anujajoshi758/Instrument-Droid/README.md

# Instrument-Droid
[Report Link](https://github.com/anujajoshi758/Instrument-Droid/blob/main/anuja_Instrument%20Droid_report.pdf)
