anujajoshi758/Instrument-Droid/anuja_Instrument Droid_report.pdf

## Board 4: Instrument Droid

Objective:

To design and implement a 4-layer standalone board using the ATmega328 microcontroller that can measure the Thevenin equivalent resistance of various DC voltage sources by sensing voltage and current under controlled load conditions.

Bill of Material:

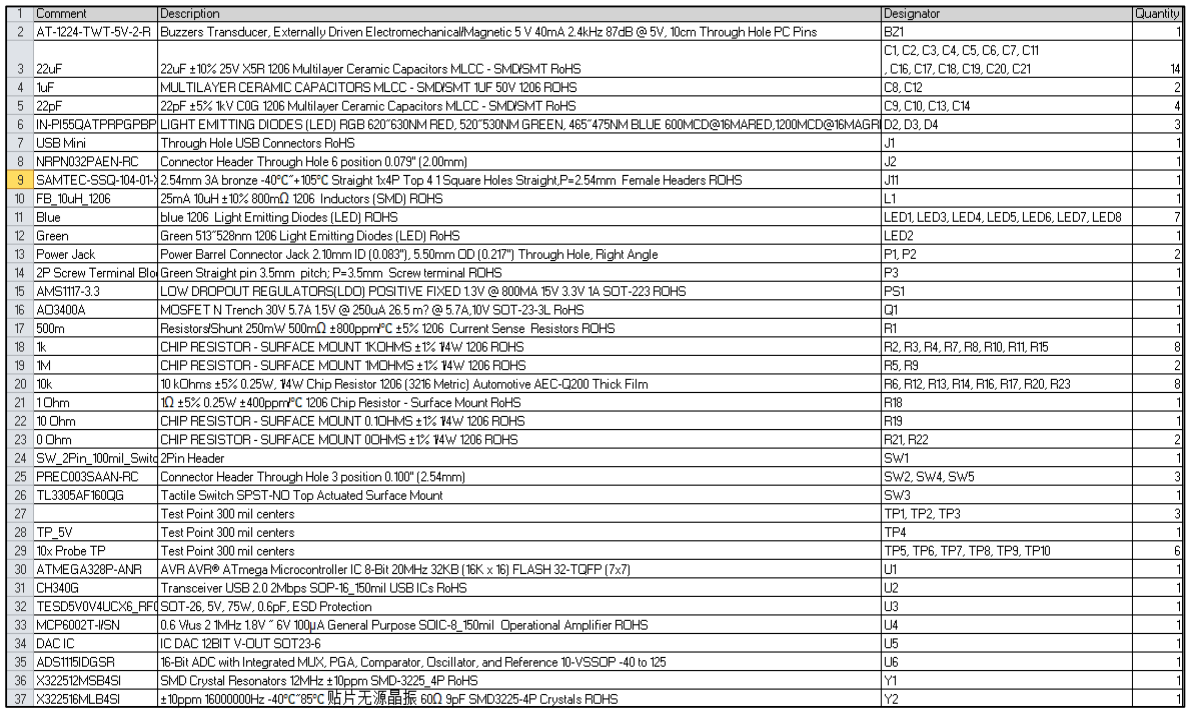
[picture p1: figure]
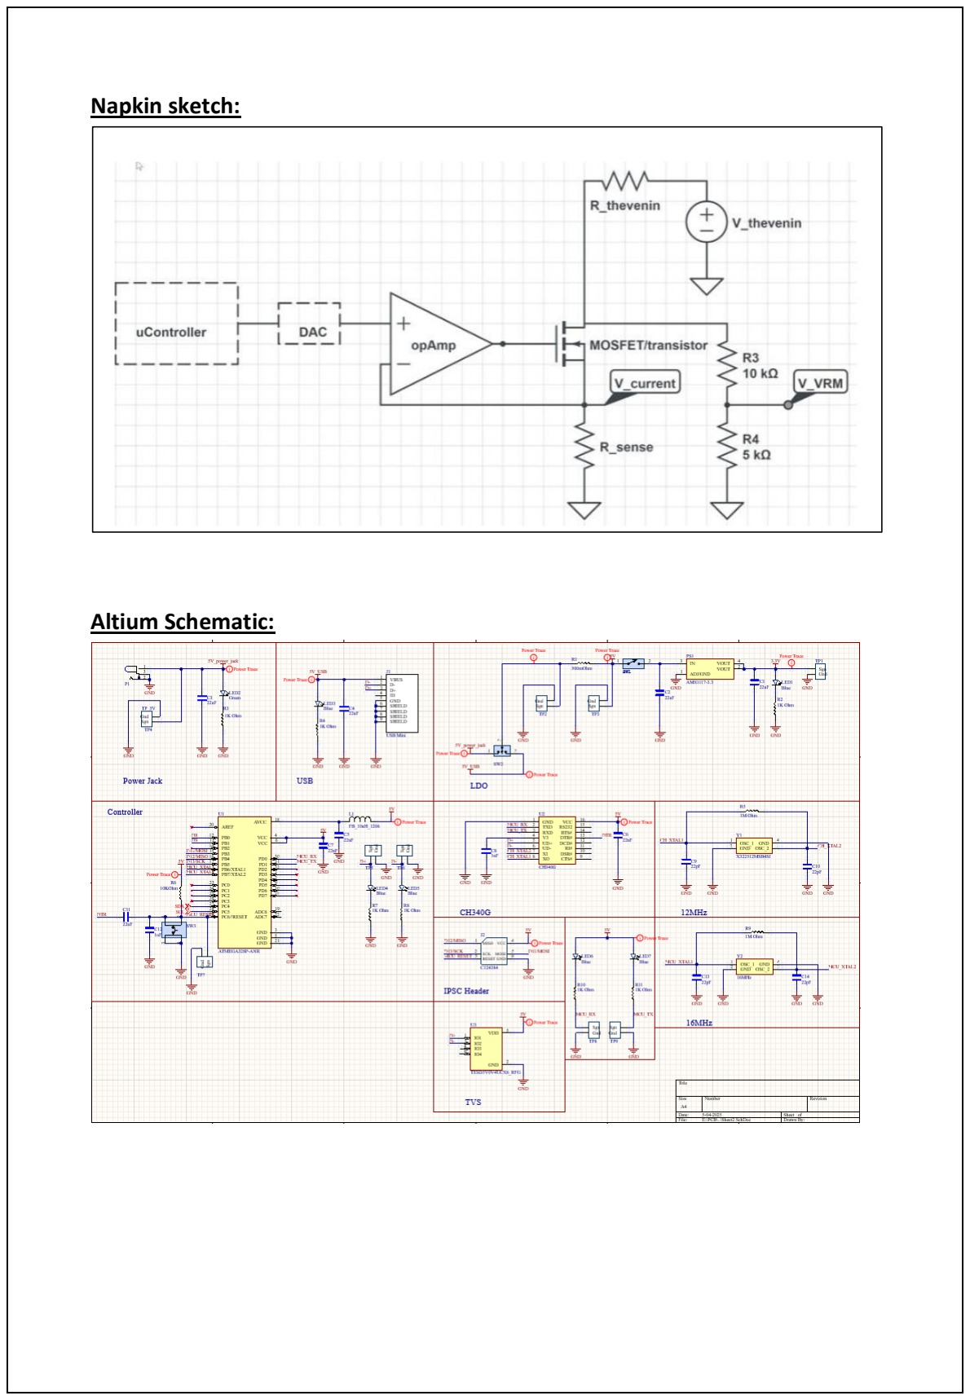
[picture p2: page 2]

Napkin sketch:

Altium Schematic:

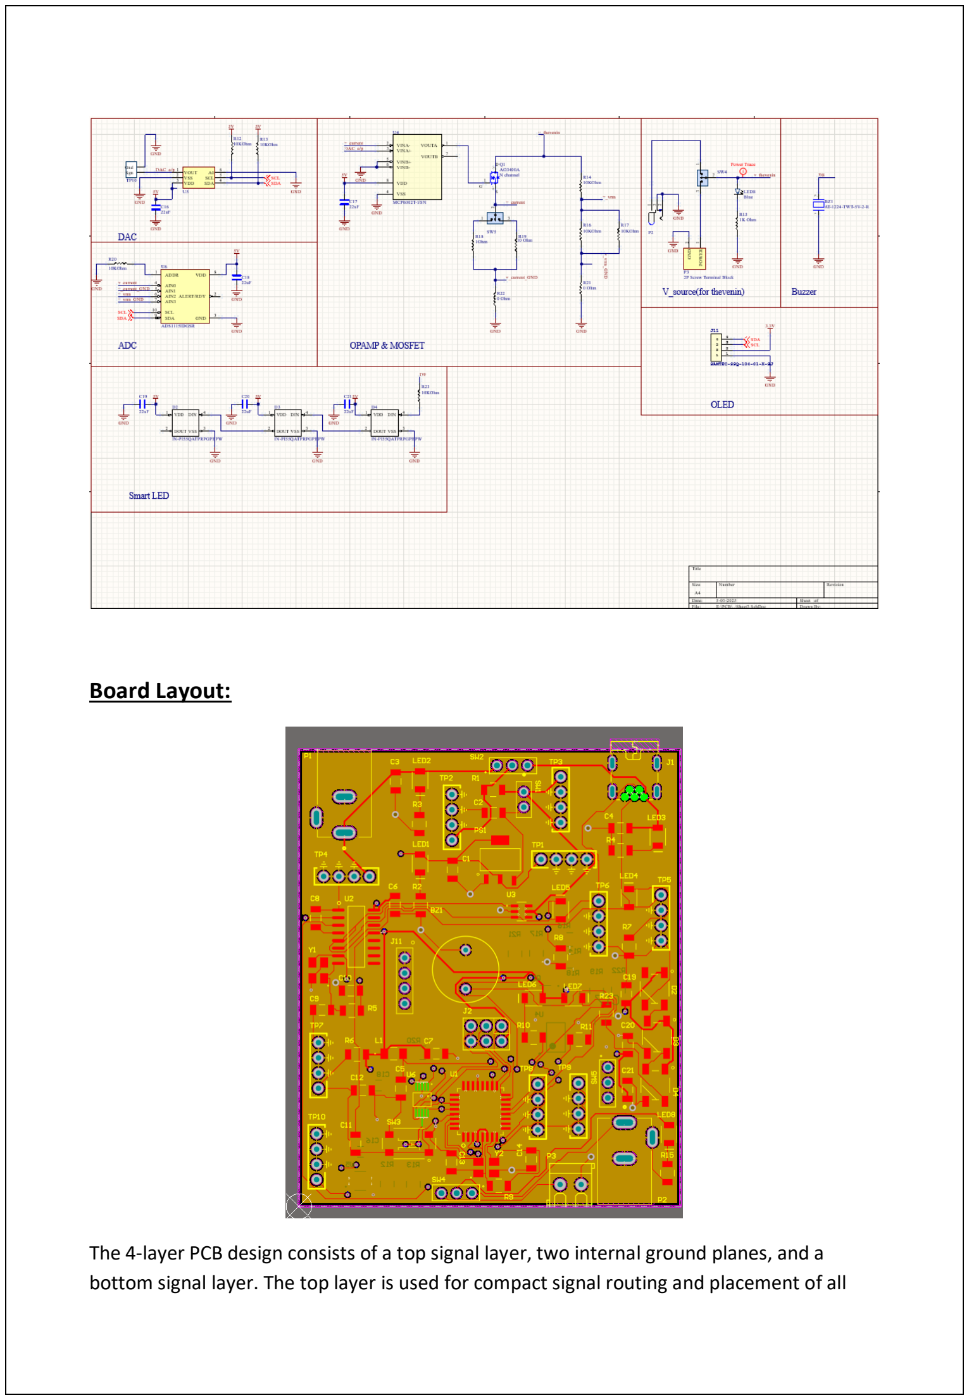
[picture p3: page 3]

Board Layout:

The 4-layer PCB design consists of a top signal layer, two internal ground planes, and a bottom signal layer. The top layer is used for compact signal routing and placement of all surface-mount components. Inner layer 1 serves as the primary ground plane, ensuring lowimpedance return paths for top-layer signals and reducing EMI. Inner layer 2 acts as a secondary ground plane, supporting high-current return paths. The bottom layer is utilized for additional signal routing, power distribution, and interfacing with through-hole connectors and test points.

Board Pictures:

Before assembly:

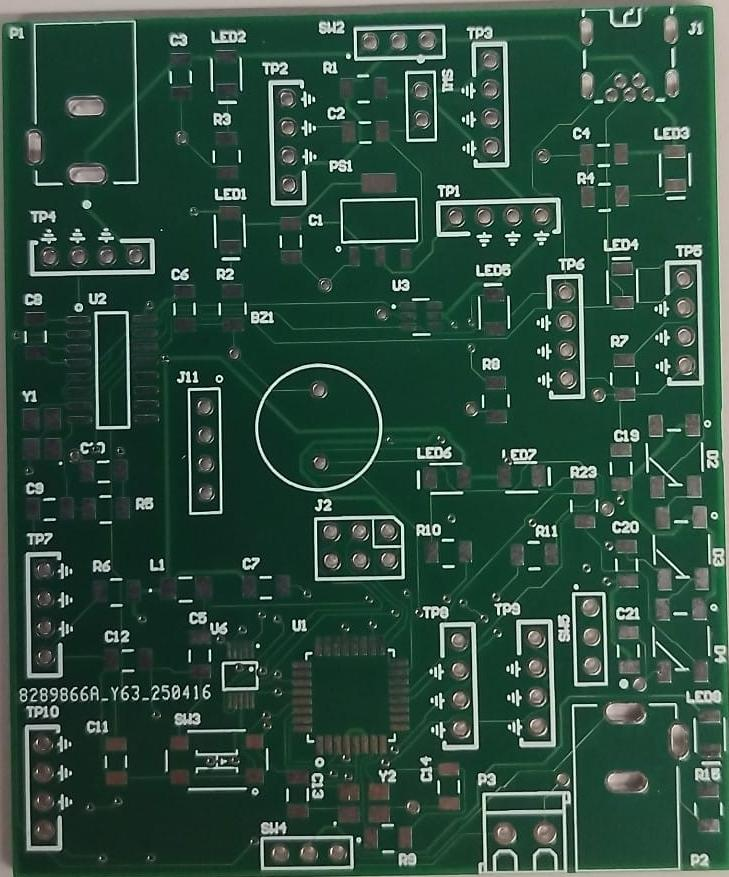
[picture p4: figure]

After assembly:

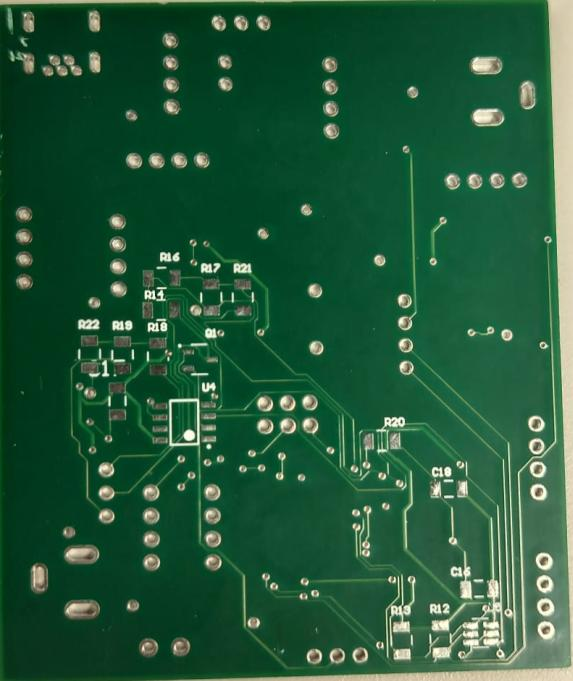
[picture p5: figure]

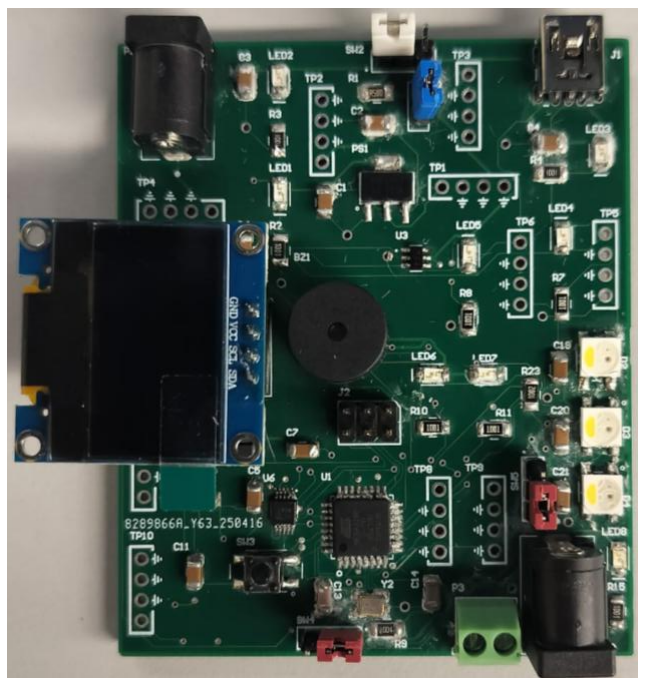
[picture p6: figure]

Plan of Record:

Power

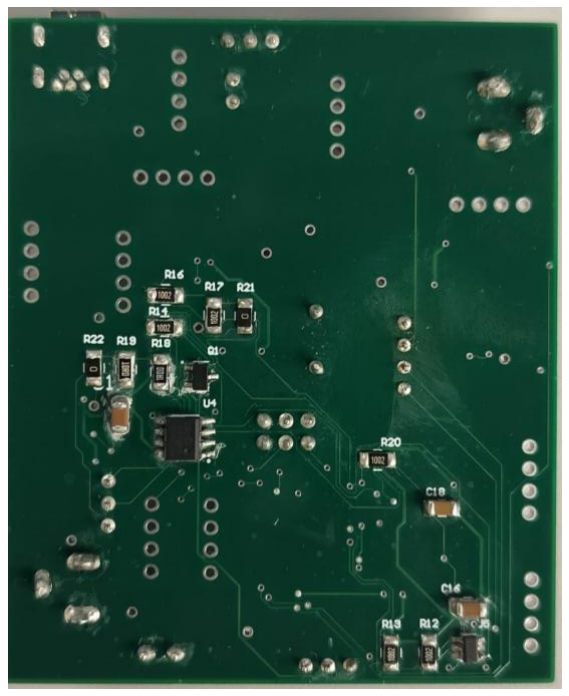
[picture p7: figure]

- Power jack for a standard “AC-to-5 V DC” adaptor (primary board supply).
- One more power jack and two-pin screw terminal for the external source whose Rthev is being measured.
- On-board slide switch selects either power jack or two pin screw terminal as the local 5 V logic supply.
- 500m ohm current-sense resistor in series with the main rail, plus nearby test pad for inrush-current probing.

Source-Under-Test

- MCP4725 12-bit DAC → MCP6002 rail-to-rail op-amp → MOSFET forms a closed-loop electronic load.
- Slide switch selects 1 ohm or 10ohm sense network at the MOSFET source to extend current range.

Measurement

- Ferrite bead on AVCC isolates the ADC/DAC analog rail from digital noise.

Bootloading

- ATmega328-P clocked by a 16 MHz crystal boot-flash accessible through a 6-pin ICSP header and isolation-header jumpers.

- CH340G (12 MHz crystal) provides USB-to-UART bridge on a mini-B connector protected by a USB-line TVS diode.

User Interface

- OLED displays real-time Rthev, load current, and rail voltage.
- Three smart LEDs.
- 5 V buzzer

Connectivity & Debug

- Labeled test.
- Isolation headers for the ATmega328 I/O and power to support subsystem bring-up.

WHAT WORKED:

Board bring up:

1. Power Indicators:

The board was successfully powered up and verified for functionality. The OLED display correctly shows real-time readings of current, voltage, and calculated Thevenin resistance. Multiple indicator LEDs are active, signaling proper power distribution, program execution, and system status. The buzzer is mounted and functional, providing audible feedback during operation. All subsystems—including power input, USB serial interface, Atmega328 bootload, OLED, DAC, ADC, MOSFET load path, and user interface—were confirmed operational during the initial bring-up.

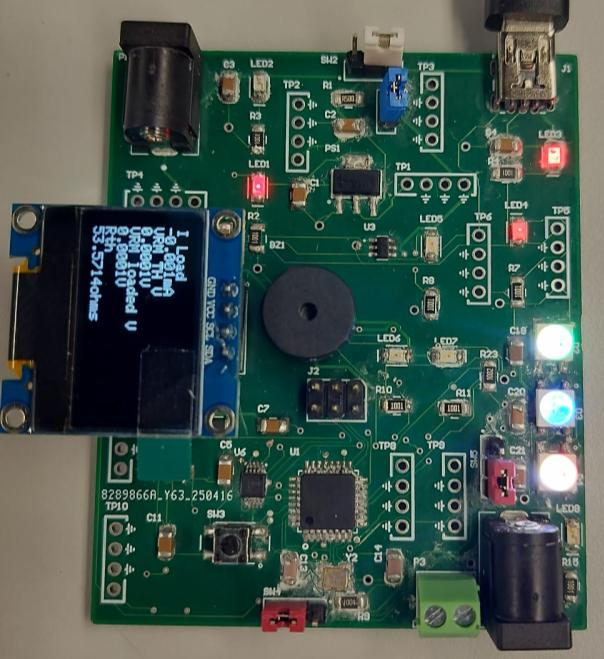
[picture p8: figure]
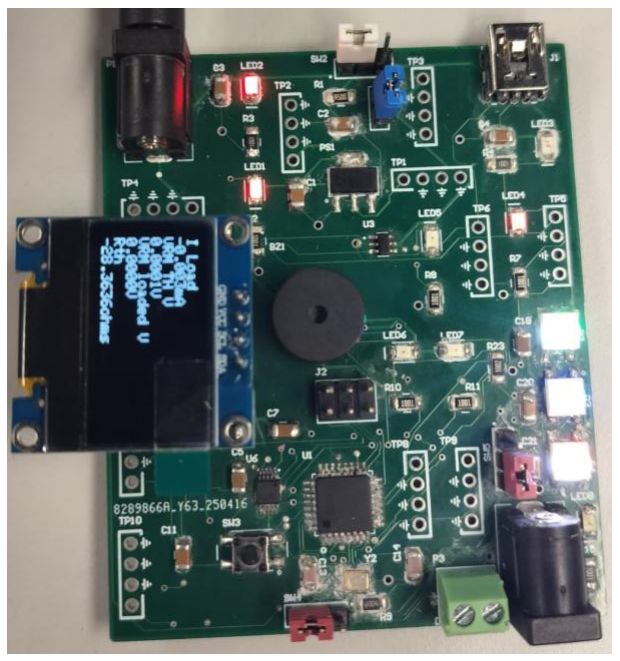
[picture p9: figure]

Power on using power USB | Power on using power jack

2. Power Source Switching:

The switch correctly toggles between USB and power (jack), with seamless power transition observed and no voltage dips.

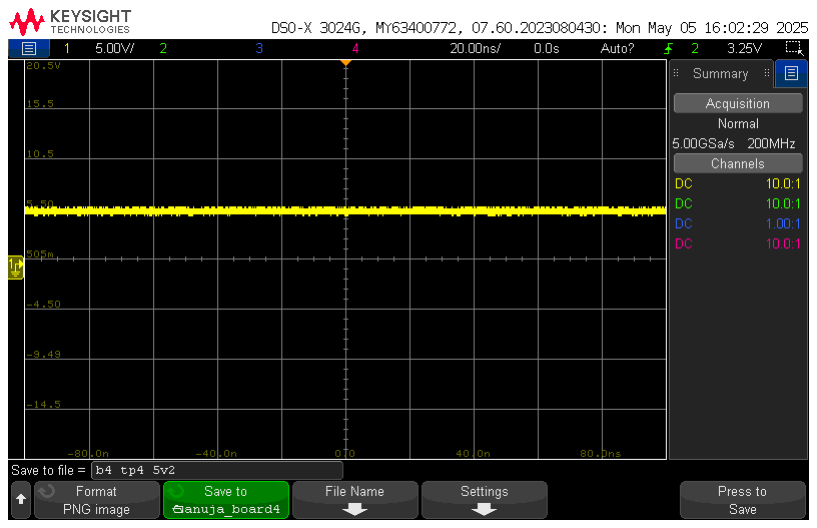
[picture p10: figure]

3. 3.3V LDO Output Verification: A stable 3.3V output was observed on the corresponding test point, confirming proper operation of the LDO regulator.

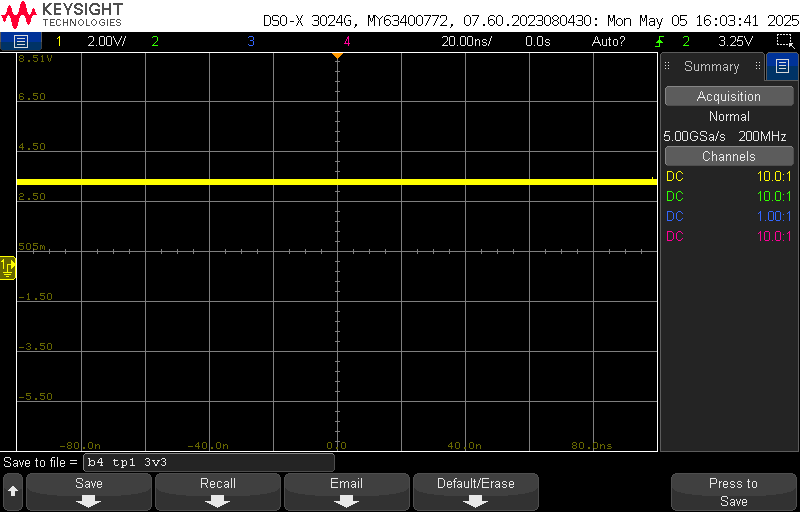
[picture p11: figure]

4. Bootloading the ATmega328:
The ATmega328 microcontroller was successfully bootloaded using a commercial Arduino Uno configured as an ISP programmer. Bootloader functionality was confirmed through successful detection in the Arduino IDE and successful sketch uploads. The crystal oscillators were verified for correct operation—16 MHz for the ATmega328 and 12 MHz for the CH340G USB-to-UART converter.

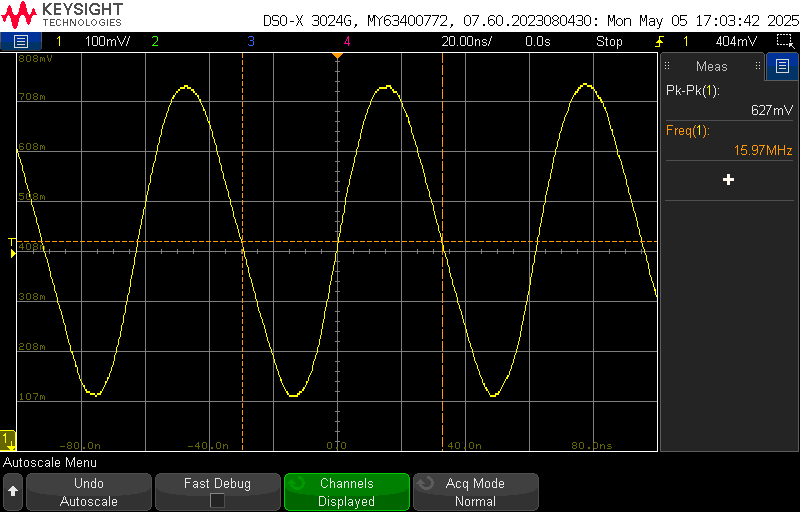
[picture p12: figure]

16MHz

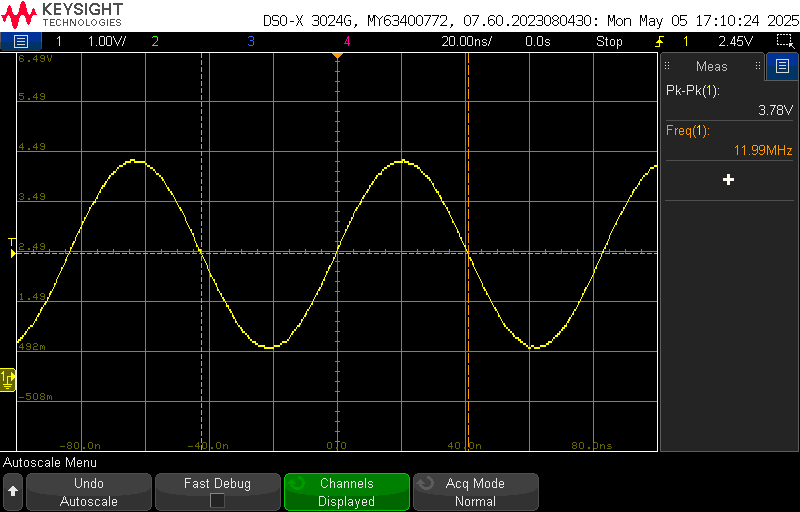
[picture p13: figure]

12MHz

5. Code Flashing and UART Communication:
Firmware was successfully flashed to the ATmega328 via the CH340G USB-to-UART interface. Oscilloscope captures on USB D+/D– lines and UART RX/TX lines confirmed active data transmission during code upload, verifying proper communication and functionality of the CH340G interface.

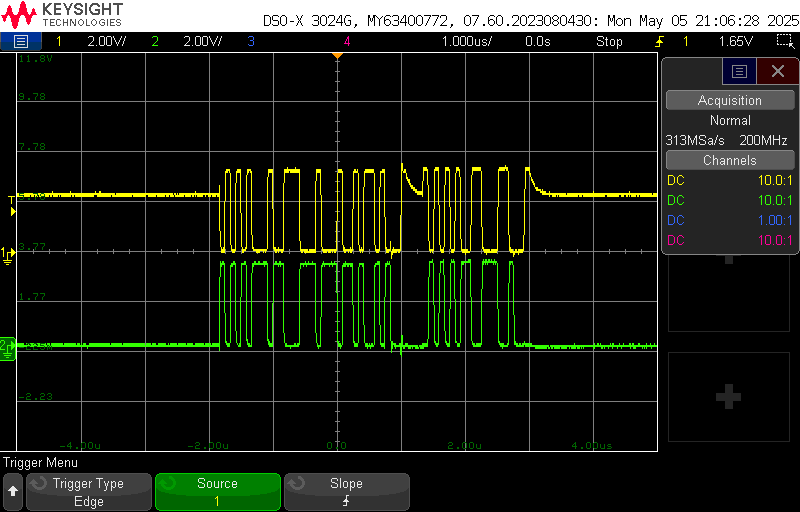
[picture p14: figure]

D+/D-

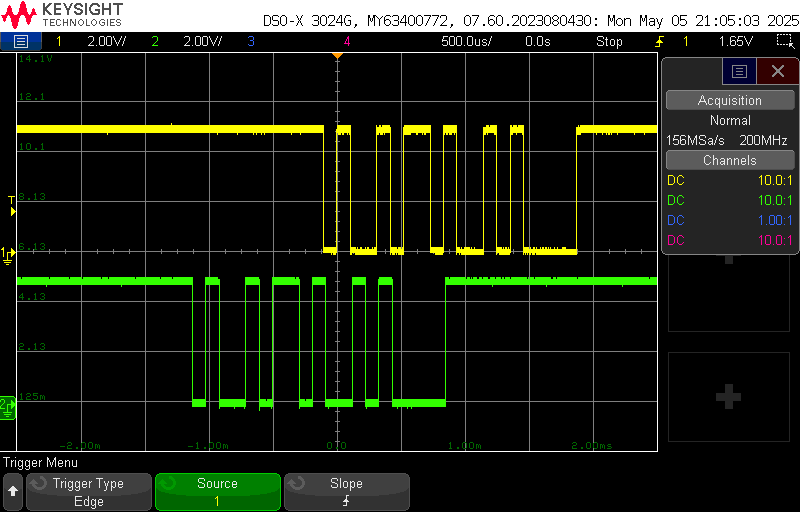
[picture p15: figure]

Tx/Rx

### 6. Flashing Buzzer and Smart LED Test Code:

Uploaded a basic test sketch via the Arduino IDE to verify functionality of the buzzer and smart LEDs. The buzzer activated with a short tone and the LEDs cycled through colors. Please find the attached code at the provided link. Check the link for the demo

demo.mp4 (https://o365coloradoedu-my.sharepoint.com/:v:/g/personal/anjo6767_colorado_edu/ETvTsv99MuFHioioCC0A-IgBFFIWDzbZSyg_gIc26YpI-w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)

7. Testing reset:
7. DAC output:

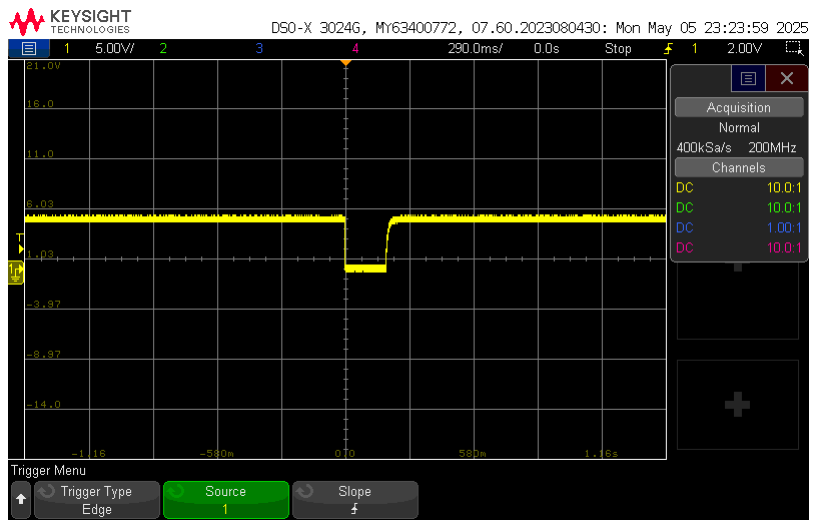
[picture p16: figure]
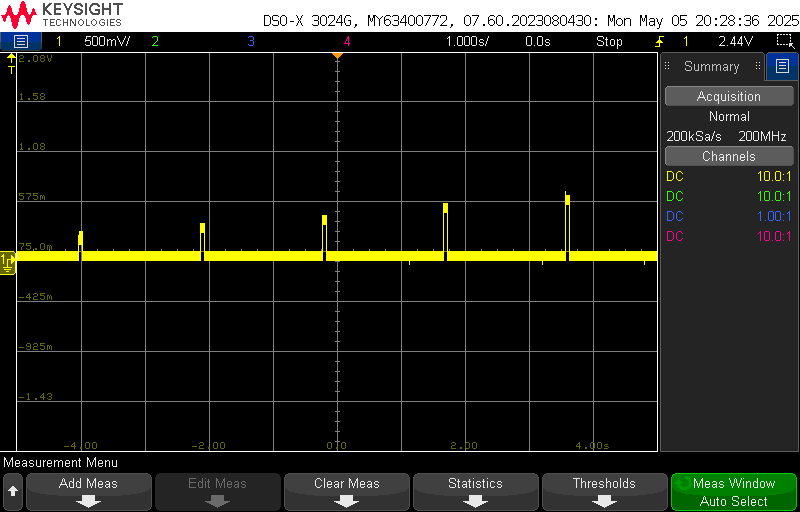
[picture p17: figure]

8. MOSFET gate

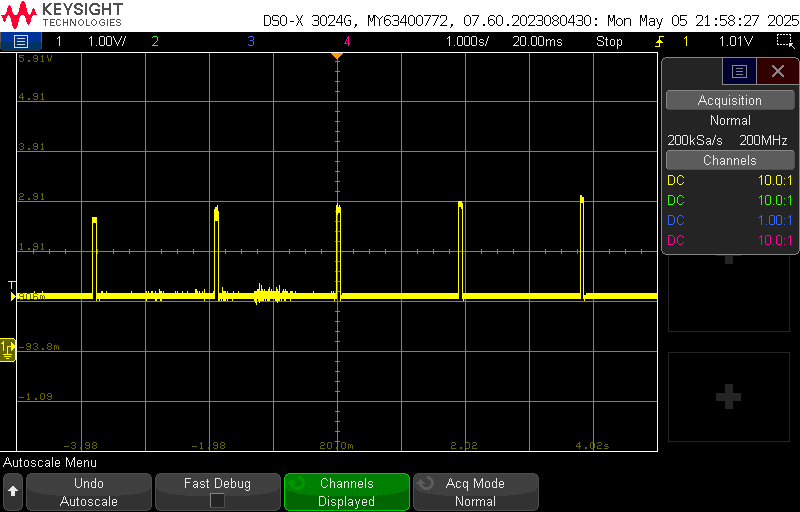
[picture p18: figure]

What Did Not Work:
All components and functionalities operated as intended. No hardware or software issues were encountered during bring-up and testing.

Measurement of Output Resistance for Connected Voltage Sources:

1. 5V adapter

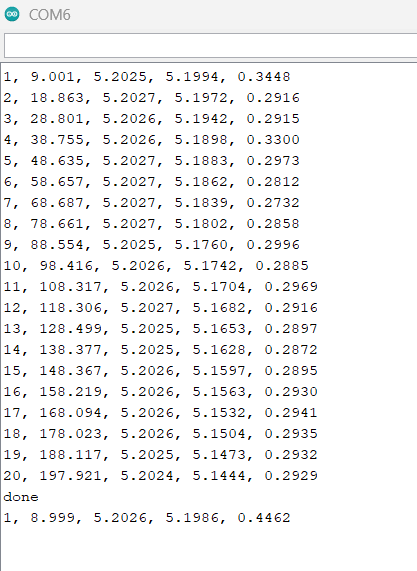
[picture p19: figure]
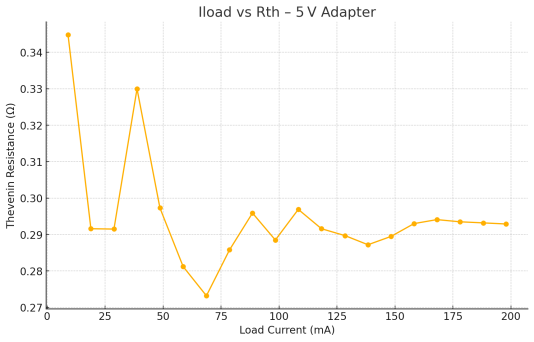
[picture p20: figure]

2. Function generator 5V:

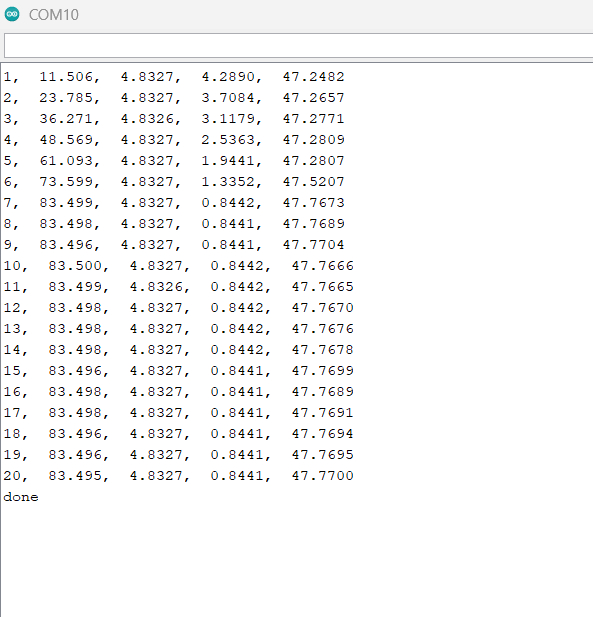
[picture p21: figure]

4. Function generator 9V:

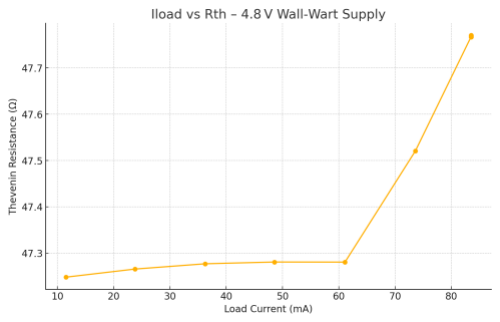
[picture p22: figure]
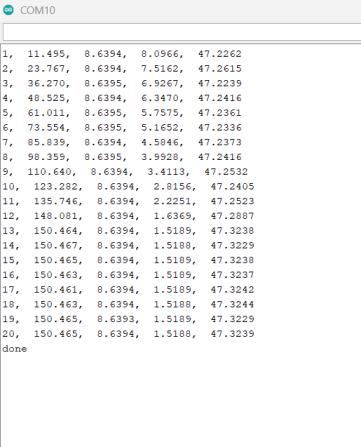
[picture p23: figure]
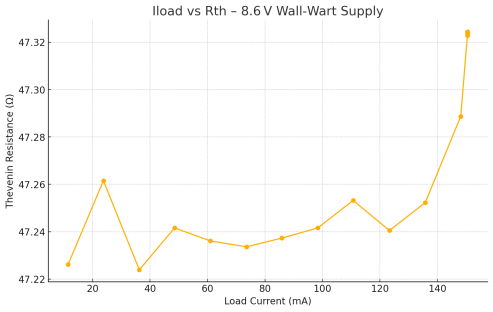
[picture p24: figure]

The instrument droid accurately measured the power adapter near-constant ≈ 47 ohm output resistance and the switch-mode adapter’s flat ≈ 0.30 ohm output resistance, demonstrating its ability to distinguish high and low impedance sources.

Conclusion:
The instrument-droid project successfully met all stated objectives: design, fabrication, bring-up, and validation of a standalone 4-layer ATmega328-based board capable of characterizing the Thevenin output resistance of DC sources up to 12 V. Hardware bring-up verified every subsystem—power inputs, USB–UART (CH340G), bootloader access, OLED display, DAC/ADC chain, MOSFET electronic load, smart LEDs, and buzzer—without encountering hardware or software faults.

Key learnings:

GPIO Silkscreen Matters: Unlabeled pins significantly slowed troubleshooting; clear GPIO labels streamline testing and save time.

ICs First: Reflowing the fine-pitch ICs before resistors, capacitors, and jumpers minimizes alignment issues and simplifies later hand-soldering.

Solder Paste Proficiency: Gained hands-on experience soldering components using solder paste, resulting in cleaner and more reliable joints for SMT parts.
