anujajoshi758/Instrument-Droid/PCB_board4_BOM.xlsx

Comment | Description | Designator | Footprint | LibRef | Quantity
AT-1224-TWT-5V-2-R | Buzzers Transducer, Externally Driven Electromechanical/Magnetic 5 V 40mA 2.4kHz 87dB @ 5V, 10cm Through Hole PC Pins | BZ1 | BUZZER- TH | BUZZER_1 | 1
22uF | 22uF ±10% 25V X5R 1206 Multilayer Ceramic Capacitors MLCC - SMD/SMT RoHS | C1, C2, C3, C4, C5, C6, C7, C11, C16, C17, C18, C19, C20, C21 | 1206_Passive_Capacitor | C_22uF_1206 | 14
1uF | MULTILAYER CERAMIC CAPACITORS MLCC - SMD/SMT 1UF 50V 1206 ROHS | C8, C12 | 1206_Passive_Capacitor | C_1uF_1206 | 2
22pF | 22pF ±5% 1kV C0G 1206 Multilayer Ceramic Capacitors MLCC - SMD/SMT RoHS | C9, C10, C13, C14 | 1206_Passive_Capacitor | C_22pF_1206 | 4
IN-PI55QATPRPGPBPW | LIGHT EMITTING DIODES (LED) RGB 620~630NM RED, 520~530NM GREEN, 465~475NM BLUE 600MCD@16MARED,1200MCD@16MAGREEN,300MCD@16MABLUE TOP VIEW SMD-4 ROHS | D2, D3, D4 | SERIAL_LED - duplicate | LED_Smart | 3
USB Mini | Through Hole USB Connectors RoHS | J1 | USB_MINI_B | J_USB_B_Mini | 1
NRPN032PAEN-RC | Connector Header Through Hole 6 position 0.079" (2.00mm) | J2 | ICSP | J_ICSP | 1
SAMTEC-SSQ-104-01-X-SJ | 2.54mm 3A bronze -40℃~+105℃ Straight 1x4P Top 4 1 Square Holes Straight,P=2.54mm Female Headers ROHS | J11 | JF-4_SSQ-104-01-X-S | JF_4_PIN_FEMALE | 1
FB_10uH_1206 | 25mA 10uH ±10% 800mΩ 1206 Inductors (SMD) ROHS | L1 | AIML-1206_ABR-M | FB_10uH_1206 | 1
Blue | blue 1206 Light Emitting Diodes (LED) ROHS | LED1, LED3, LED4, LED5, LED6, LED7, LED8 | LED_1206 | LED_BLUE_1206 | 7
Green | Green 513~528nm 1206 Light Emitting Diodes (LED) RoHS | LED2 | LED_1206 | LED_GREEN_1206 | 1
Power Jack | Power Barrel Connector Jack 2.10mm ID (0.083"), 5.50mm OD (0.217") Through Hole, Right Angle | P1, P2 | Power_Jack | P_Power Jack | 2
2P Screw Terminal Block | Green Straight pin 3.5mm pitch; P=3.5mm Screw terminal ROHS | P3 | P_Terminal block 3.5mm-pitch | P_Terminal block | 1
AMS1117-3.3 | LOW DROPOUT REGULATORS(LDO) POSITIVE FIXED 1.3V @ 800MA 15V 3.3V 1A SOT-223 ROHS | PS1 | LDO | PS_AMS_LDO_3v3 | 1
AO3400A | MOSFET N Trench 30V 5.7A 1.5V @ 250uA 26.5 m? @ 5.7A,10V SOT-23-3L RoHS | Q1 | N-MOSFET | Q_Nch_MOSFET | 1
500m | Resistors/Shunt 250mW 500mΩ ±800ppm/℃ ±5% 1206 Current Sense Resistors ROHS | R1 | 1206_Passive_Resitor | R_500mOhm_1206 | 1
1k | CHIP RESISTOR - SURFACE MOUNT 1KOHMS ±1% 1/4W 1206 ROHS | R2, R3, R4, R7, R8, R10, R11, R15 | 1206_Passive_Resitor | R_1K_1206 | 8
1M | CHIP RESISTOR - SURFACE MOUNT 1MOHMS ±1% 1/4W 1206 ROHS | R5, R9 | 1206_Passive_Resitor | R_1M_1206 | 2
10k | 10 kOhms ±5% 0.25W, 1/4W Chip Resistor 1206 (3216 Metric) Automotive AEC-Q200 Thick Film | R6, R12, R13, R14, R16, R17, R20, R23 | 1206_Passive_Resitor | R_10KOhm_1206 | 8
1 Ohm | 1Ω ±5% 0.25W ±400ppm/℃ 1206 Chip Resistor - Surface Mount RoHS | R18 | 1206_Passive_Resitor | R_1Ohm_1206 | 1
10 Ohm | CHIP RESISTOR - SURFACE MOUNT 0.1OHMS ±1% 1/4W 1206 ROHS | R19 | 1206_Passive_Resitor | R_10Ohm_1206 | 1
0 Ohm | CHIP RESISTOR - SURFACE MOUNT 0OHMS ±1% 1/4W 1206 ROHS | R21, R22 | 1206_Passive_Resitor | R_0Ohm_1206 | 2
SW_2Pin_100mil_Switch | 2Pin Header | SW1 | 2Pin-Header-Conn | SW_2Pin_100mil_Switch | 1
PREC003SAAN-RC | Connector Header Through Hole 3 position 0.100" (2.54mm) | SW2, SW4, SW5 | 3_PIN_100mil | SW_3Pin_100mil_Switch | 3
TL3305AF160QG | Tactile Switch SPST-NO Top Actuated Surface Mount | SW3 | Switch_JLC | SW_Push_Button_JLC | 1
 | Test Point 300 mil centers | TP1, TP2, TP3 | TP10x_Probe | TP_10x_Probe | 3
TP_5V | Test Point 300 mil centers | TP4 | TP10x_Probe | TP_10x_Probe | 1
10x Probe TP | Test Point 300 mil centers | TP5, TP6, TP7, TP8, TP9, TP10 | TP10x_Probe | TP_10x_Probe | 6
ATMEGA328P-ANR | AVR AVR® ATmega Microcontroller IC 8-Bit 20MHz 32KB (16K x 16) FLASH 32-TQFP (7x7) | U1 | ATMega328P | U_ATMega328P | 1
CH340G | Transceiver USB 2.0 2Mbps SOP-16_150mil USB ICs RoHS | U2 | USB to serial | U_USBtoSerial | 1
TESD5V0V4UCX6_RFG | SOT-26, 5V, 75W, 0.6pF, ESD Protection | U3 | SOT95P280X145-6N | TESD5V0V4UCX6_RFG | 1
MCP6002T-I/SN | 0.6 V/us 2 1MHz 1.8V ~ 6V 100μA General Purpose SOIC-8_150mil Operational Amplifier ROHS | U4 | SOIC127P600X175-8N | U_MCP6002T-I/SN | 1
DAC IC | IC DAC 12BIT V-OUT SOT23-6 | U5 | MCP4725 | U_MCP4725A0T-E/CH | 1
ADS1115IDGSR | 16-Bit ADC with Integrated MUX, PGA, Comparator, Oscillator, and Reference 10-VSSOP -40 to 125 | U6 | ADC_ADS1115IDGSR | U_ADC_ADS1115IDGSR | 1
X322512MSB4SI | SMD Crystal Resonators 12MHz ±10ppm SMD-3225_4P RoHS | Y1 | Crystal resonator | X_12MHz_Res | 1
X322516MLB4SI | ±10ppm 16000000Hz -40℃~85℃ 贴片无源晶振 60Ω 9pF SMD3225-4P Crystals ROHS | Y2 | Crystal resonator | X_16Mhz_Res | 1
