anujajoshi758/Instrument-Droid/(list of files, drawings)

Other design files:
PCB_board4.PrjPcb
pcb_board4_final.PcbDoc
Sheet2.SchDoc
Sheet3.SchDoc
